evolutek/carte-clavier/(commit log)

2020-12-26 First schematic
    [Carte Clavier V1.kicad_pcb, Carte Clavier V1.sch]
2020-12-28 Fixed schematic
    [Carte Clavier V1.sch]
2020-12-29 Add fans + Started pcb
    [Carte Clavier V1.kicad_pcb, Carte Clavier V1.sch]
2020-12-30 First attempt: not good
    [Carte Clavier V1.kicad_pcb]
2020-12-31 V1 more or less done
    [Carte Clavier V1.kicad_pcb, Carte Clavier V1.sch]
2020-12-31 Add V1.0 Release
    [Carte Clavier V1.kicad_pcb]
2021-01-09 Fixed button led intensity
    [Carte Clavier V1.kicad_pcb, Carte Clavier V1.sch]
2021-01-24 Update the 3D model of the board
2021-01-31 bom, pdf
    [Carte Clavier V1.kicad_pcb]
2021-02-28 Fixed bicolor led
    [Carte Clavier V1.kicad_pcb, Carte Clavier V1.sch]
